juan-karacho/pocket-hang-drum/Pocket Hang Drum Wiring Diagram.png

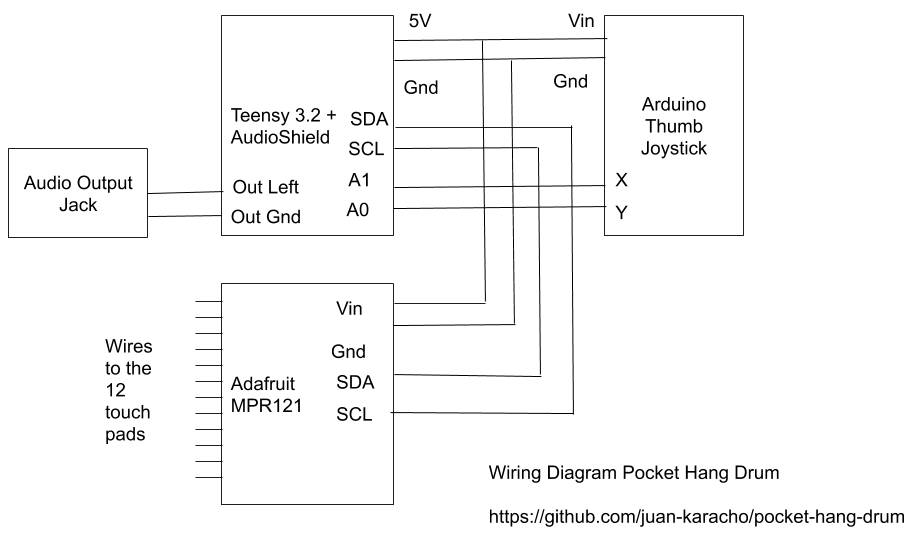
Pocket Hang Drum Wiring Diagram.png
